Samay-J/Robotic-Arm/Arm_Bot_STLs/CADs/5_DOF_ARM_Assembly.SLDASM

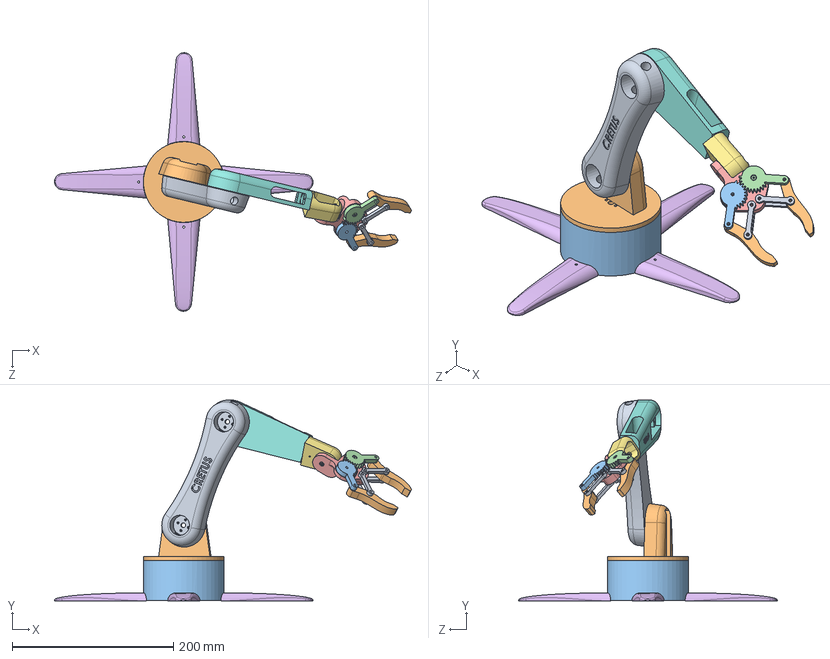
[picture p1: CAD file, 2026-10-31]
Arm_Bot_STLs/CADs/5_DOF_ARM_Assembly.SLDASM
442.5 x 249.0 x 320.5 mm
Circular_Base
Rotating_Waste
Arm_1
Arm_2
Arm_3
Base_Finger x 4
Base
Gear_Arm_1
Gear_Arm_2
Grip x 2
Link x 4
