Samay-J/Robotic-Arm/Arm_Bot_STLs/CADs/Arm_1.SLDPRT

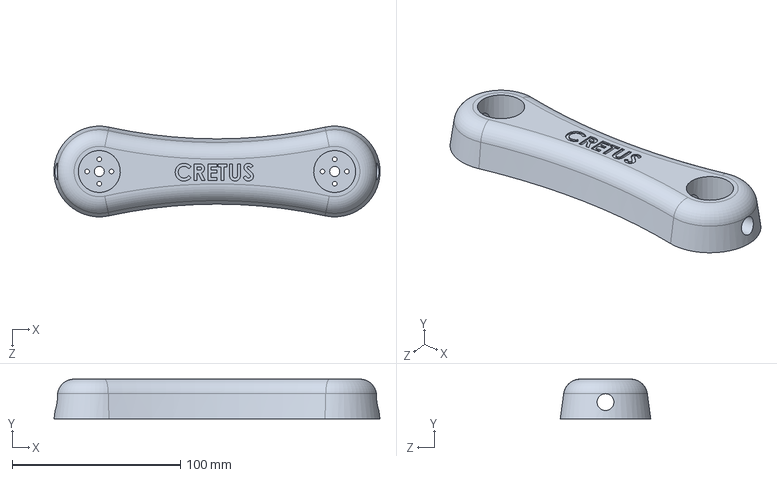
[picture p2: CAD file, 2026-10-31]
Arm_Bot_STLs/CADs/Arm_1.SLDPRT
193.9 x 23.7 x 53.9 mm
