Samay-J/Robotic-Arm/sim/ui/stl/Gear_Arm_2.STL

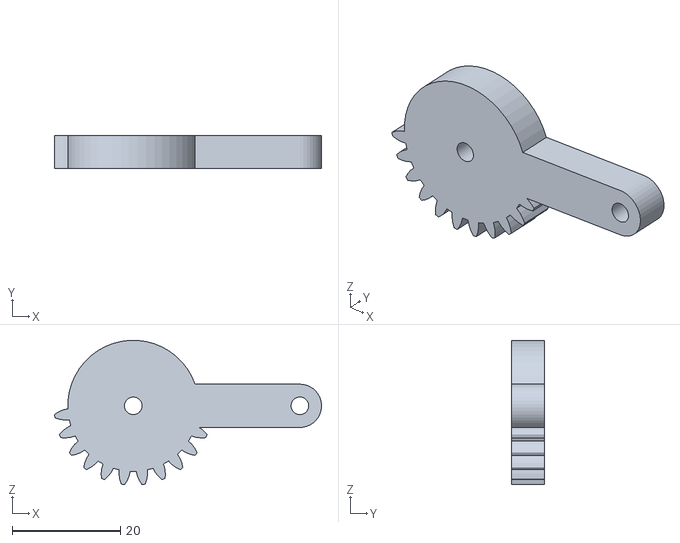
[picture p3: CAD file, 2026-10-31]
sim/ui/stl/Gear_Arm_2.STL
49.3 x 6.00 x 26.6
