Samay-J/Robotic-Arm/Arm_Bot_STLs/CADs/Grip.SLDPRT

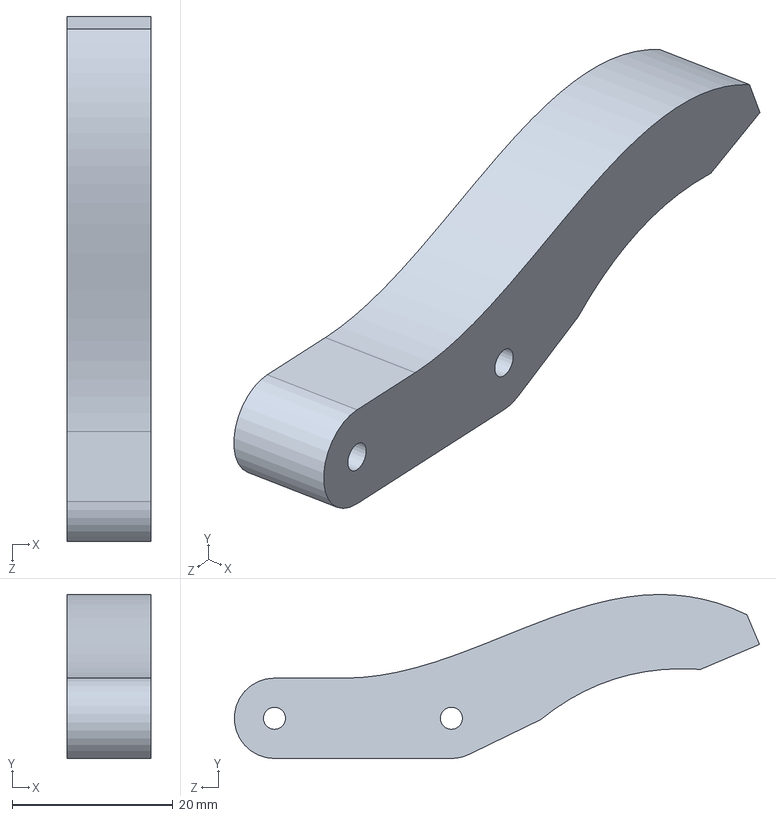
[picture p4: CAD file, 2026-10-31]
Arm_Bot_STLs/CADs/Grip.SLDPRT
10.5 x 20.4 x 65.3 mm
