Samay-J/Robotic-Arm/sim/ui/stl/Circular_Base.STL

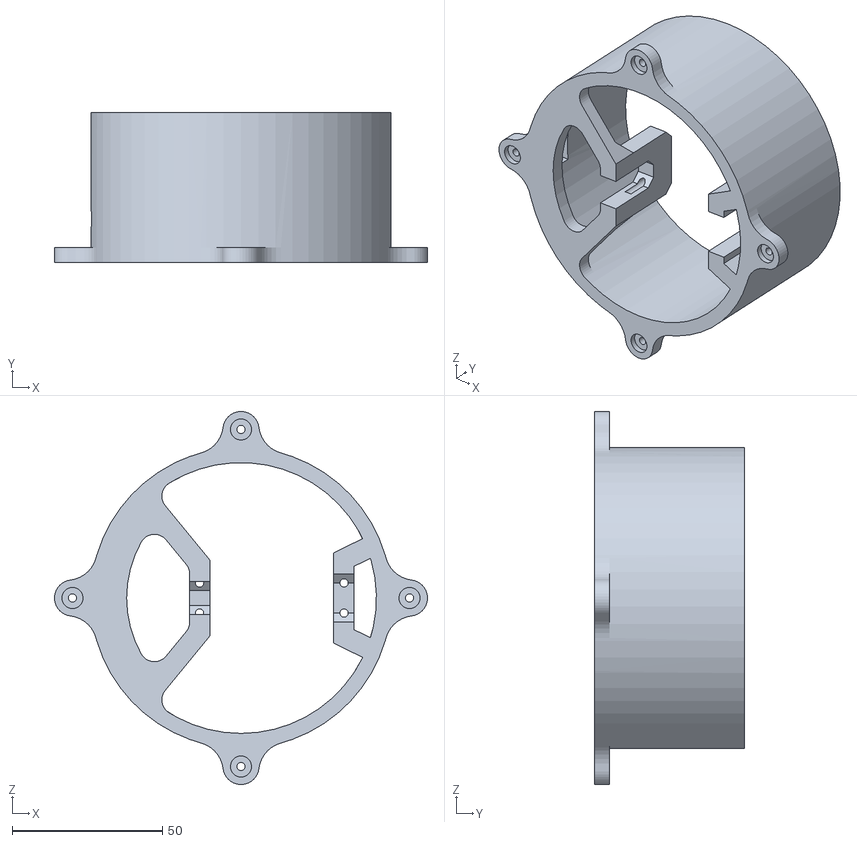
[picture p5: CAD file, 2026-10-31]
sim/ui/stl/Circular_Base.STL
124.0 x 50.0 x 124.0
