Samay-J/Robotic-Arm/Arm_Bot_STLs/CADs/Link.SLDPRT

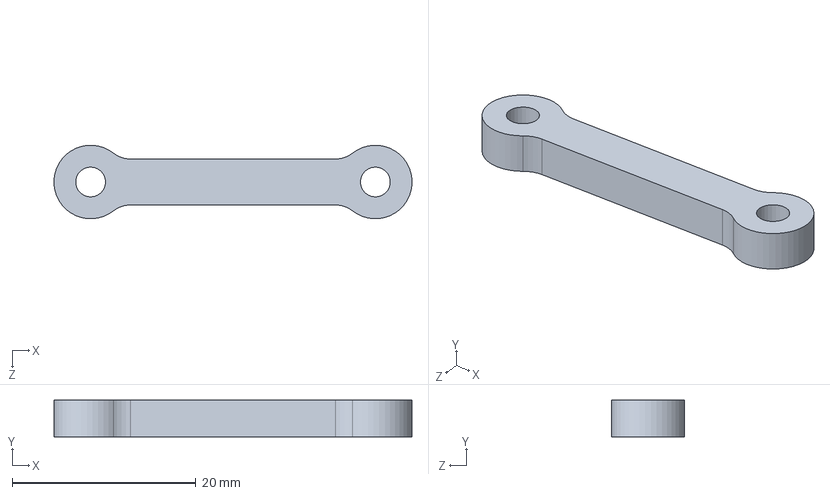
[picture p6: CAD file, 2026-10-31]
Arm_Bot_STLs/CADs/Link.SLDPRT
39.0 x 4.00 x 7.99 mm
