Samay-J/Robotic-Arm/sim/ui/stl/Rotating_Waste.STL

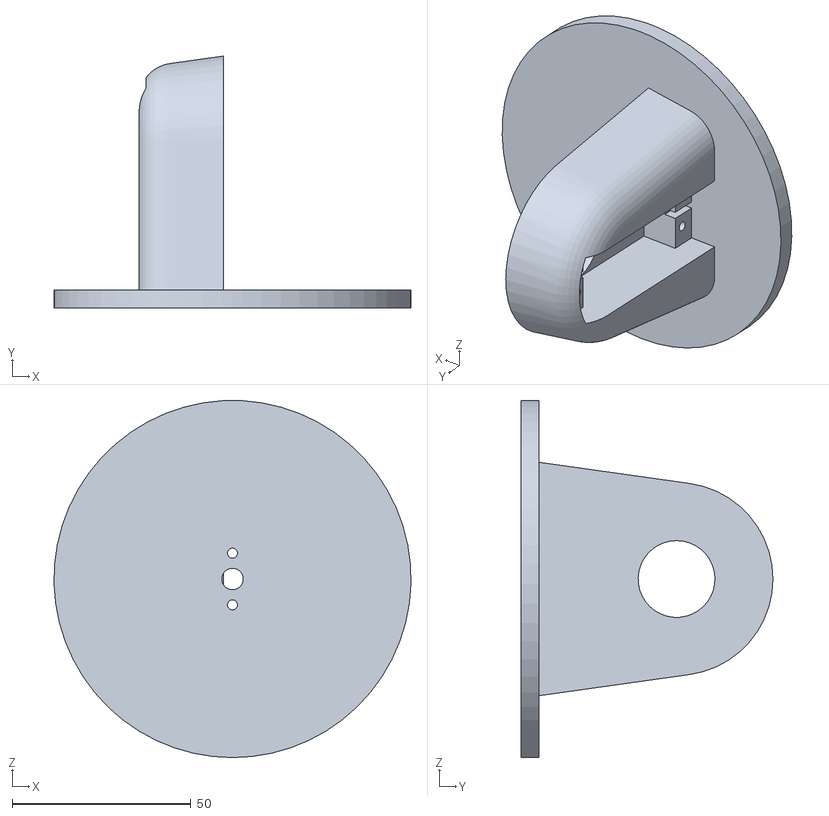
[picture p7: CAD file, 2026-10-31]
sim/ui/stl/Rotating_Waste.STL
100.0 x 70.6 x 100.0
