Samay-J/Robotic-Arm/Arm_Bot_STLs/CADs/Base_Finger.SLDPRT

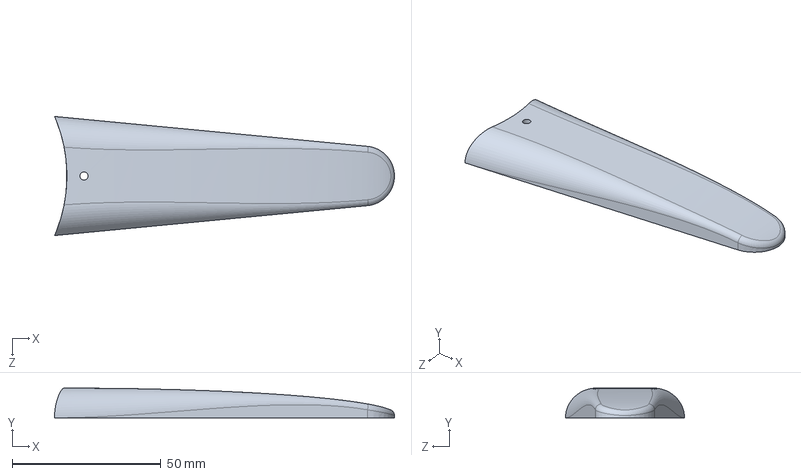
[picture p8: CAD file, 2026-10-31]
Arm_Bot_STLs/CADs/Base_Finger.SLDPRT
114.2 x 10.0 x 40.0 mm
