Samay-J/Robotic-Arm/Arm_Bot_STLs/CADs/Arm_3.SLDPRT

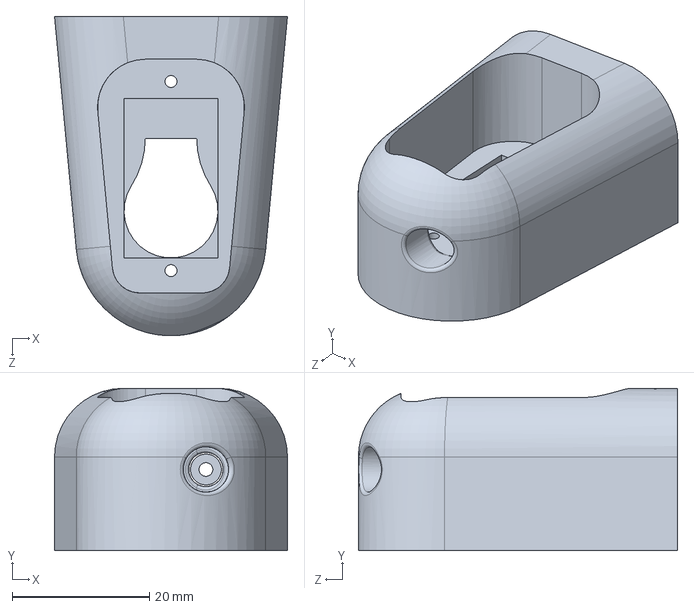
[picture p9: CAD file, 2026-10-31]
Arm_Bot_STLs/CADs/Arm_3.SLDPRT
34.0 x 23.7 x 46.6 mm
