Samay-J/Robotic-Arm/sim/ui/stl/Base.STL

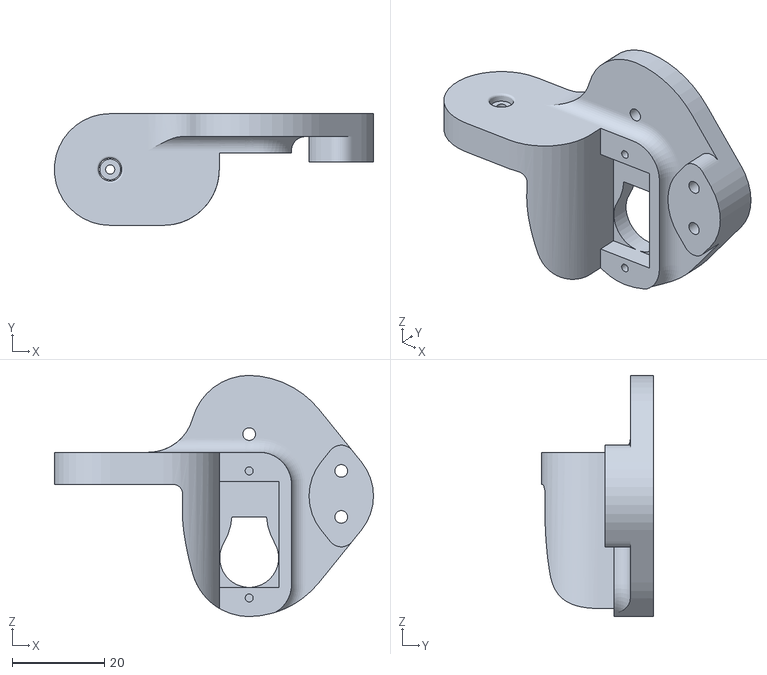
[picture p10: CAD file, 2026-10-31]
sim/ui/stl/Base.STL
69.3 x 24.3 x 52.4
