Samay-J/Robotic-Arm/sim/ui/stl/Arm_2.STL

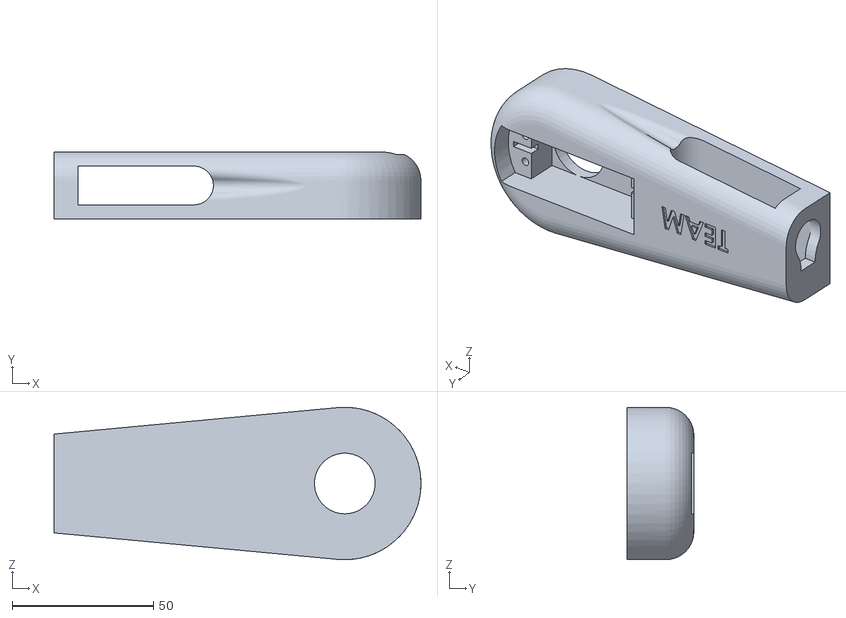
[picture p11: CAD file, 2026-10-31]
sim/ui/stl/Arm_2.STL
130.0 x 23.7 x 54.0
