Samay-J/Robotic-Arm/Arm_Bot_STLs/CADs/Rotating_Waste.SLDPRT

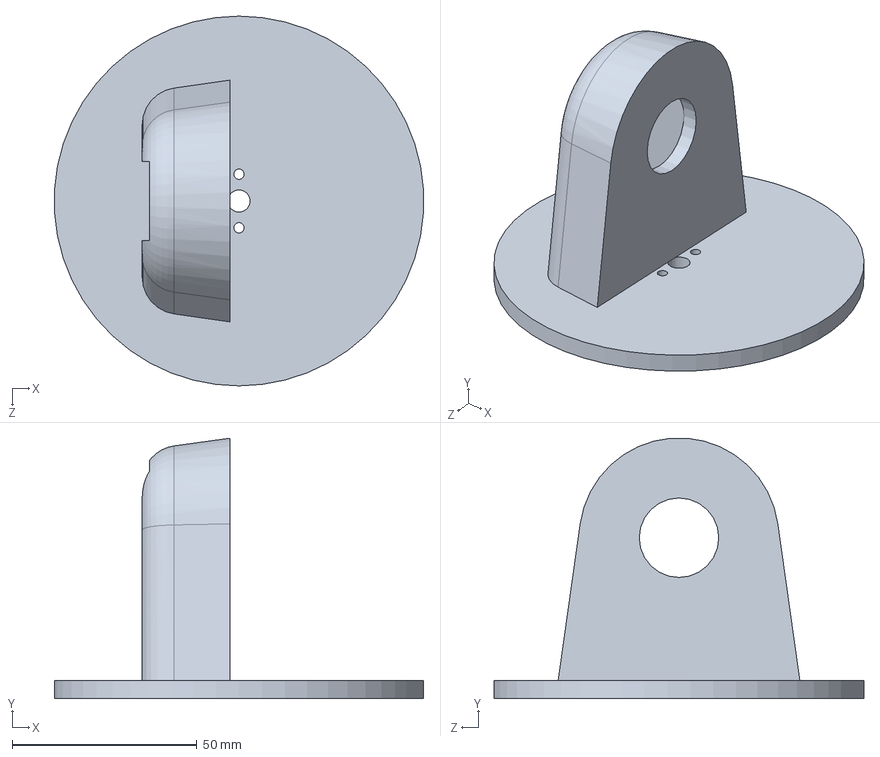
[picture p12: CAD file, 2026-10-31]
Arm_Bot_STLs/CADs/Rotating_Waste.SLDPRT
99.8 x 70.5 x 100.0 mm
