Samay-J/Robotic-Arm/sim/ui/stl/Grip.STL

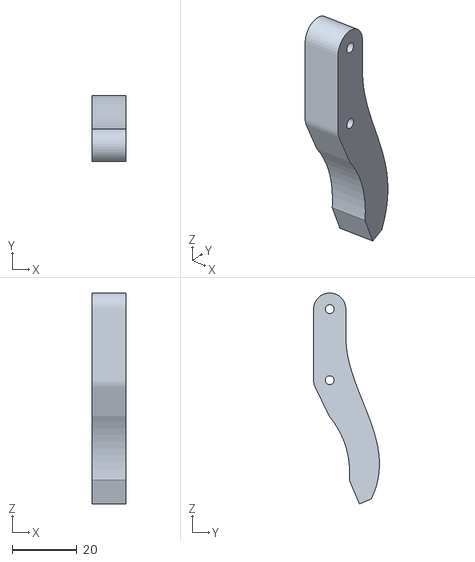
[picture p13: CAD file, 2026-10-31]
sim/ui/stl/Grip.STL
10.5 x 20.4 x 65.3
