Samay-J/Robotic-Arm/(list of files, cad)

Other CAD files:
Arm_Bot_STLs/CADs/Gear_Arm_2.SLDPRT
sim/ui/stl/Gear_Arm_1.STL
sim/ui/stl/Arm_1.STL
sim/ui/stl/Link.STL
Arm_Bot_STLs/CADs/Gear_Arm_1.SLDPRT
Arm_Bot_STLs/CADs/Arm_2.SLDPRT
sim/ui/stl/Arm_3.STL
sim/ui/stl/Base_Finger.STL
Arm_Bot_STLs/CADs/Base.SLDPRT
Arm_Bot_STLs/CADs/Circular_Base.SLDPRT
