Samay-J/Robotic-Arm/(commit log)

2026-10-31 Initial FK IK
    [Arm_1.STL, Arm_2.STL, Arm_3.STL, Base.STL, Base_Finger.STL, Circular_Base.STL, Gear_Arm_1.STL, Gear_Arm_2.STL]
2026-10-31 Final with ui
    [5_DOF_ARM_Assembly.SLDASM, Arm_1.SLDPRT, Arm_1.STL, Arm_2.SLDPRT, Arm_2.STL, Arm_3.SLDPRT, Arm_3.STL, Base.SLDPRT]
